har-man-dev/rocket-flight-computer/images/IMG_8844.jpeg

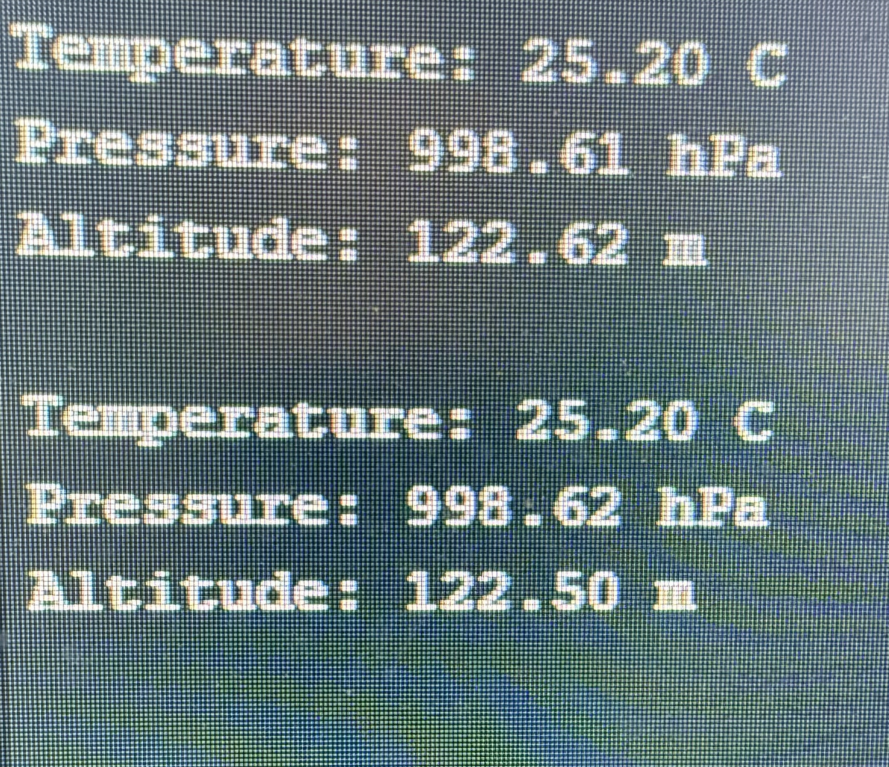
images/IMG_8844.jpeg
