har-man-dev/rocket-flight-computer/images/IMG_8843.jpeg

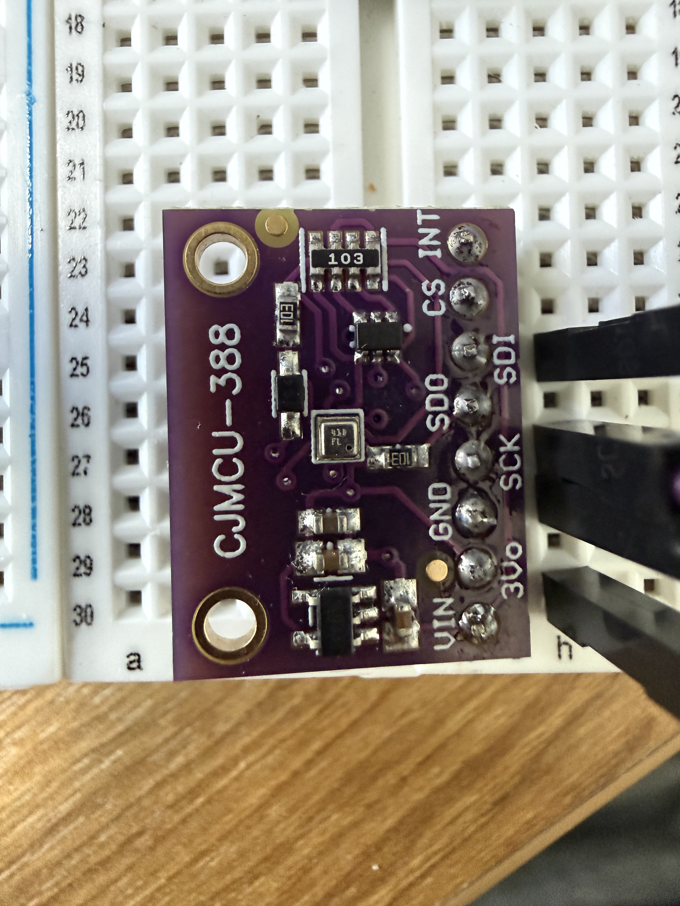
images/IMG_8843.jpeg
