har-man-dev/rocket-flight-computer/images/IMG_8841.jpeg

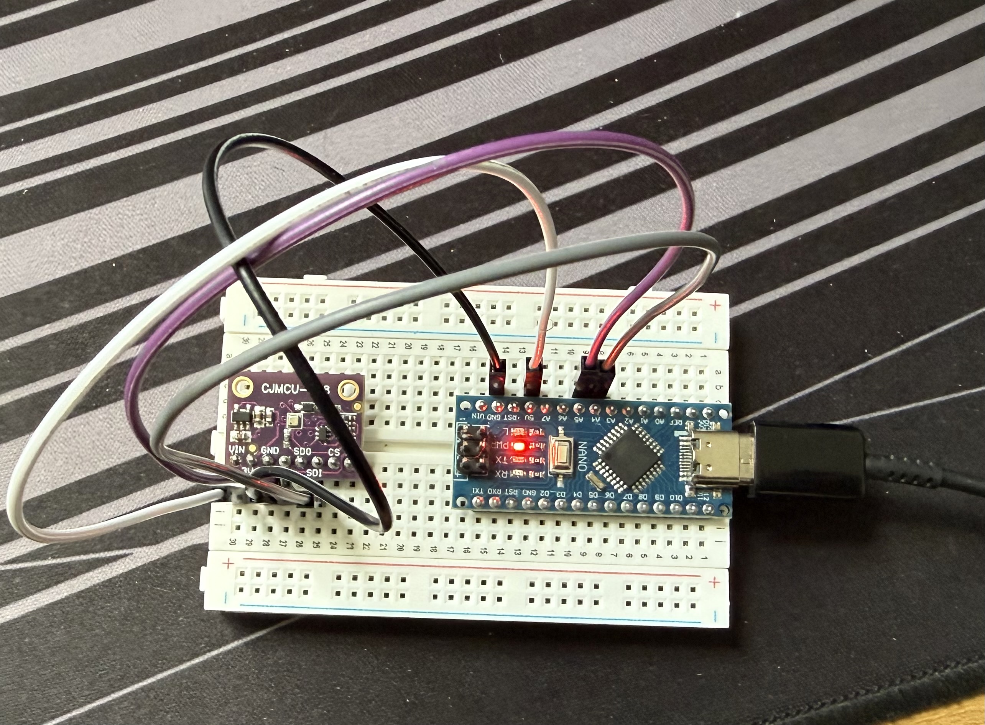
images/IMG_8841.jpeg
