har-man-dev/rocket-flight-computer/images/IMG_8845.jpeg

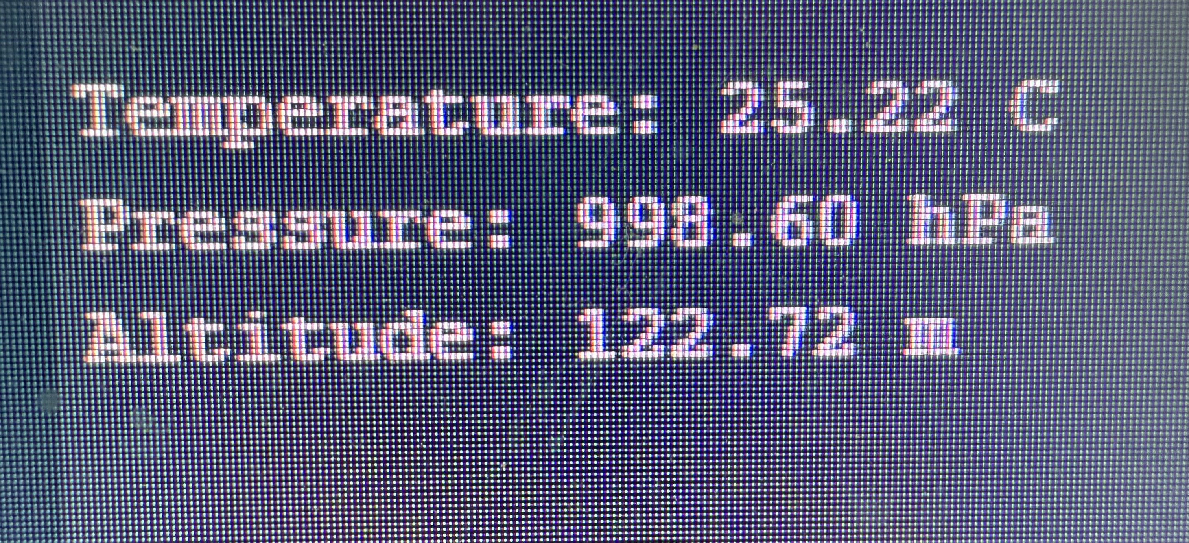
images/IMG_8845.jpeg
