har-man-dev/rocket-flight-computer/images/IMG_8846.jpeg

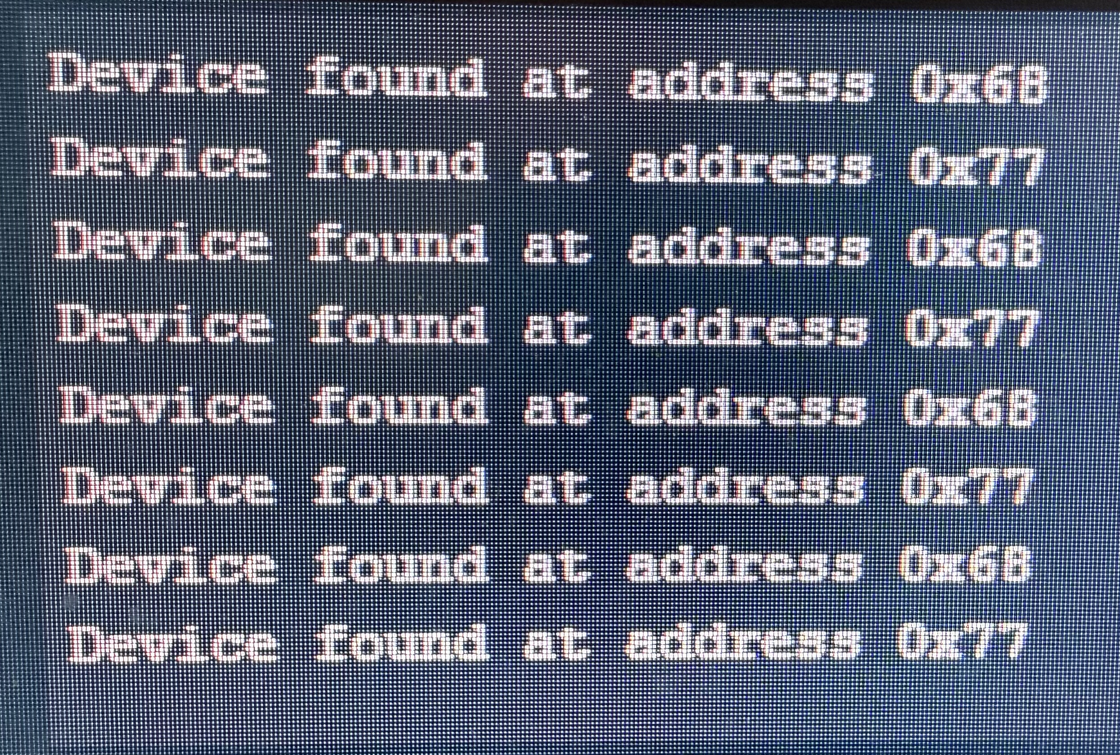
images/IMG_8846.jpeg
