har-man-dev/rocket-flight-computer/images/IMG_8848.jpeg

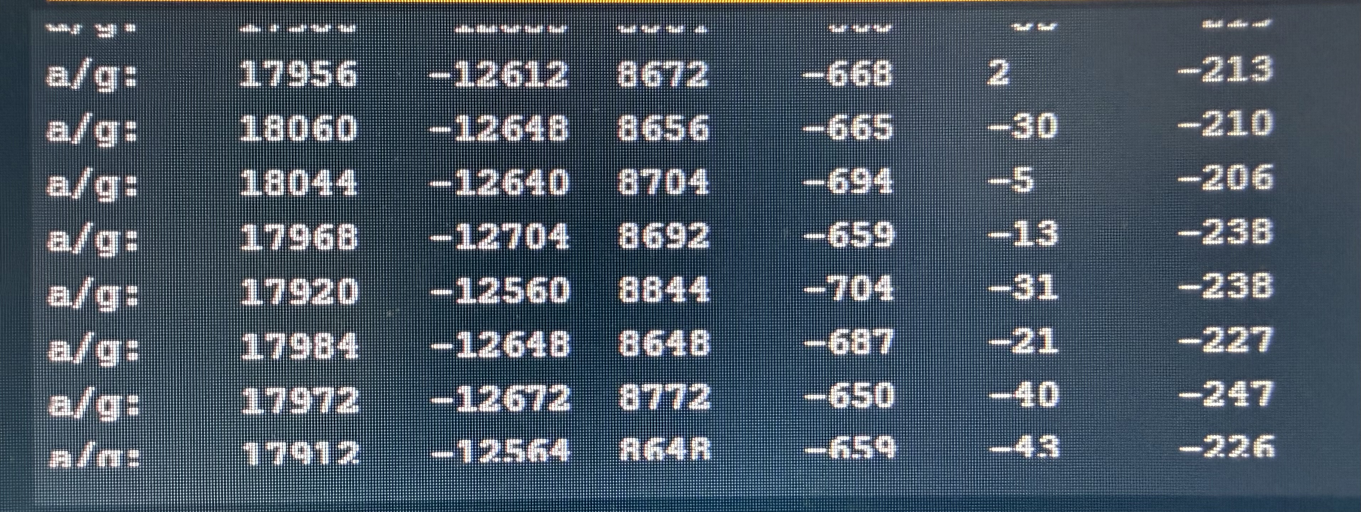
images/IMG_8848.jpeg
