har-man-dev/rocket-flight-computer/images/IMG_8849.jpeg

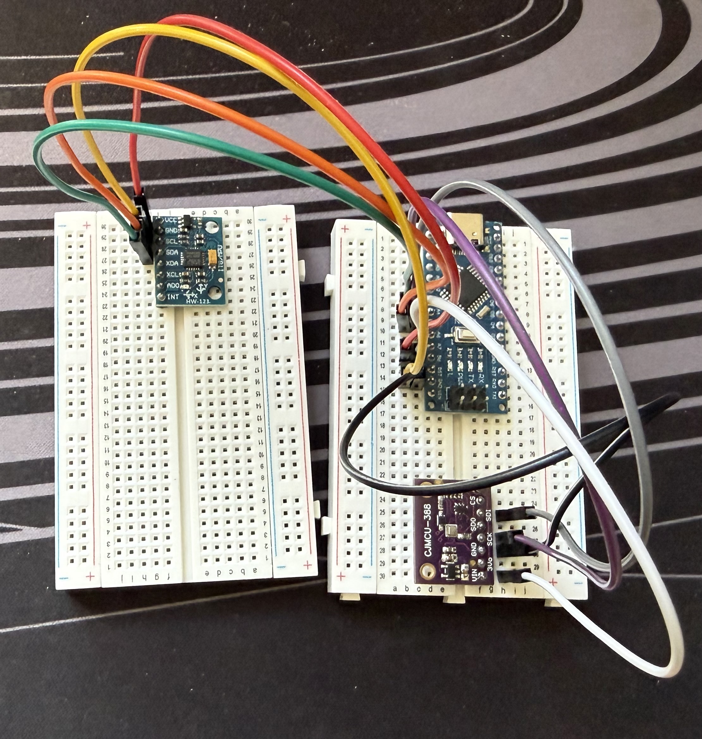
images/IMG_8849.jpeg
