har-man-dev/rocket-flight-computer/images/IMG_8850.jpeg

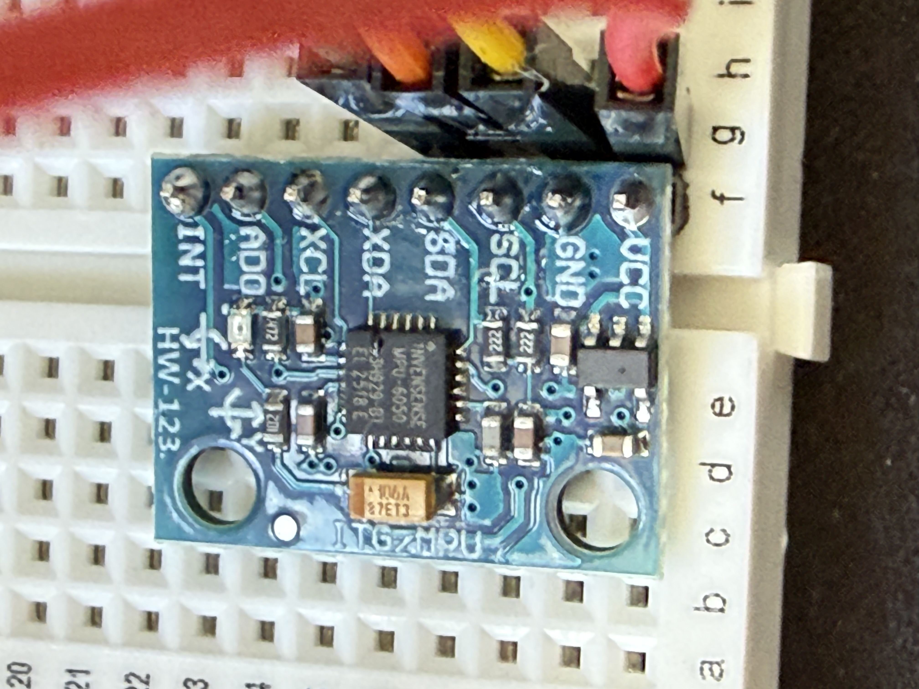
images/IMG_8850.jpeg
