har-man-dev/rocket-flight-computer/images/IMG_8851.jpeg

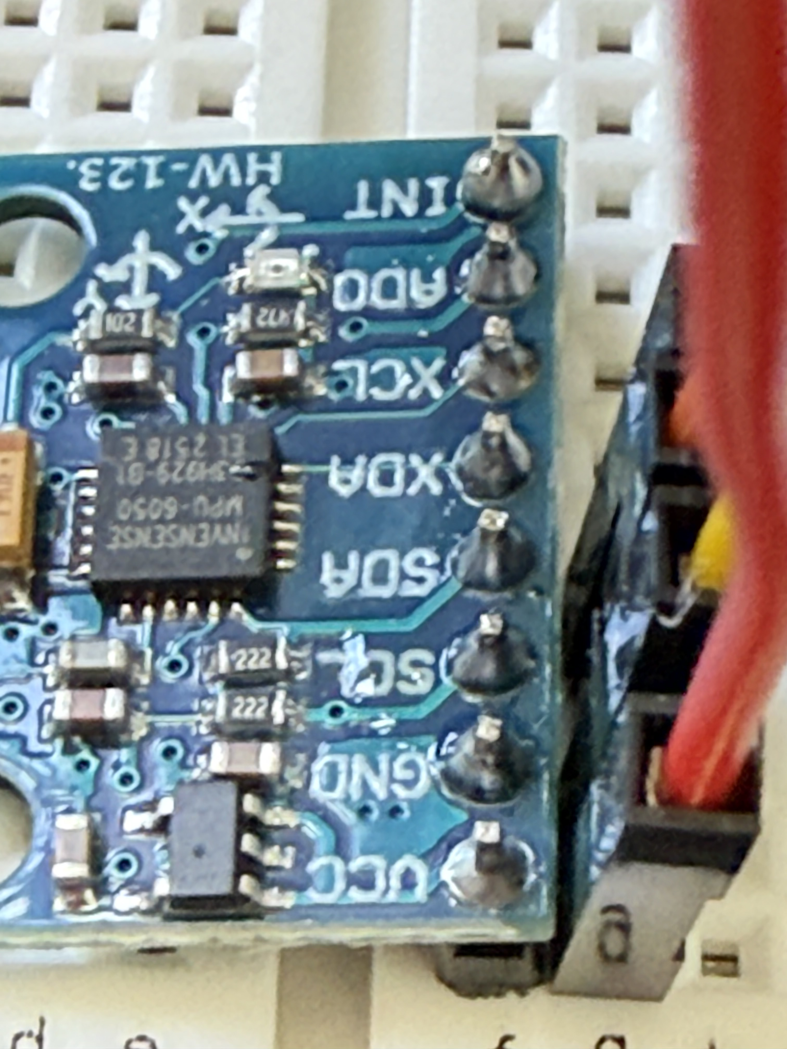
images/IMG_8851.jpeg
