har-man-dev/rocket-flight-computer/images/IMG_8867.jpeg

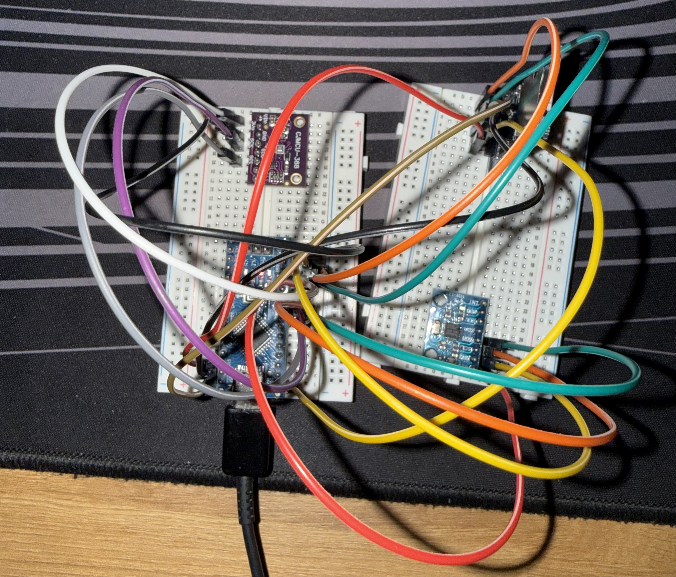
images/IMG_8867.jpeg
