har-man-dev/rocket-flight-computer/images/IMG_8871.jpeg

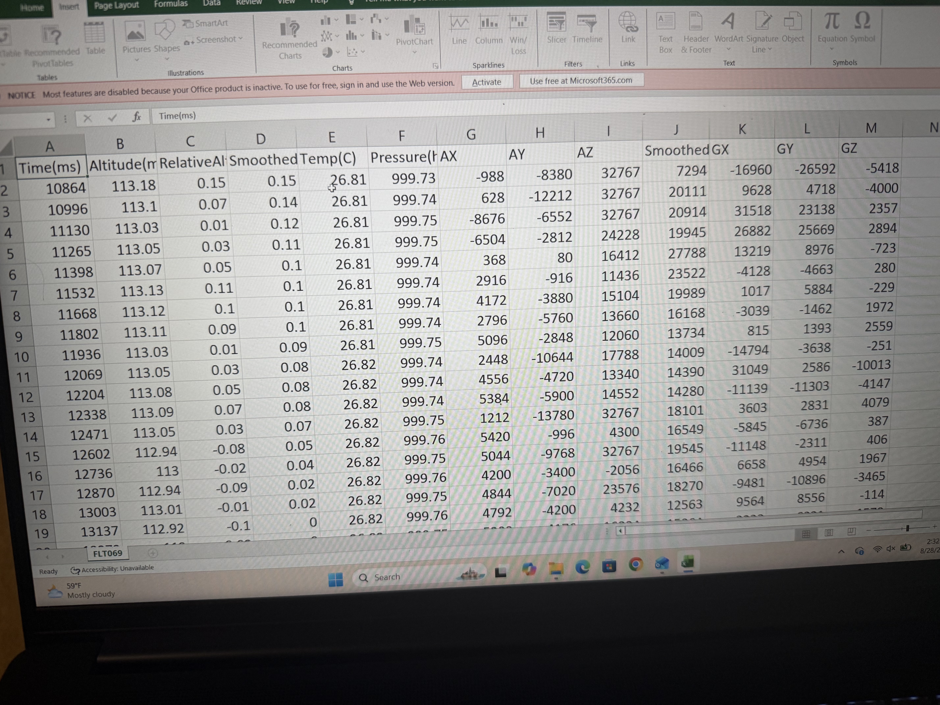
images/IMG_8871.jpeg
