har-man-dev/rocket-flight-computer/images/IMG_8945.jpeg

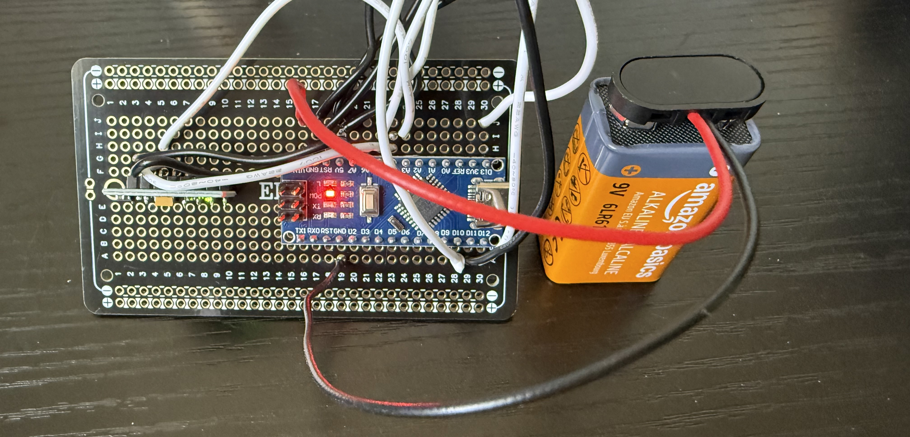
images/IMG_8945.jpeg
