har-man-dev/rocket-flight-computer/images/IMG_8947.jpeg

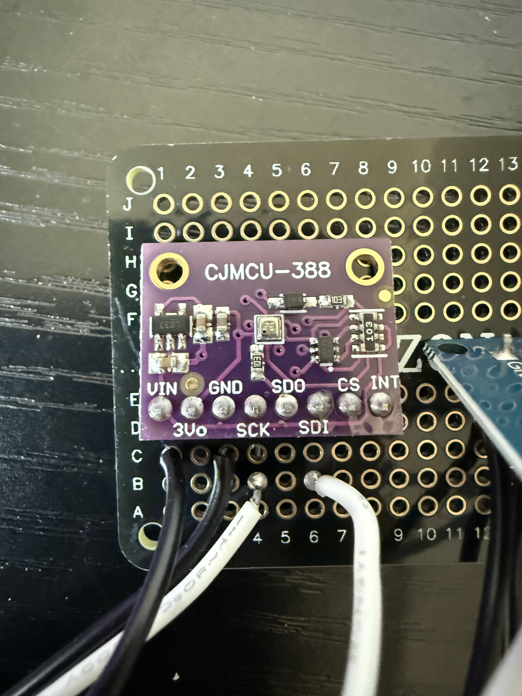
images/IMG_8947.jpeg
