har-man-dev/rocket-flight-computer/images/IMG_8948.jpeg

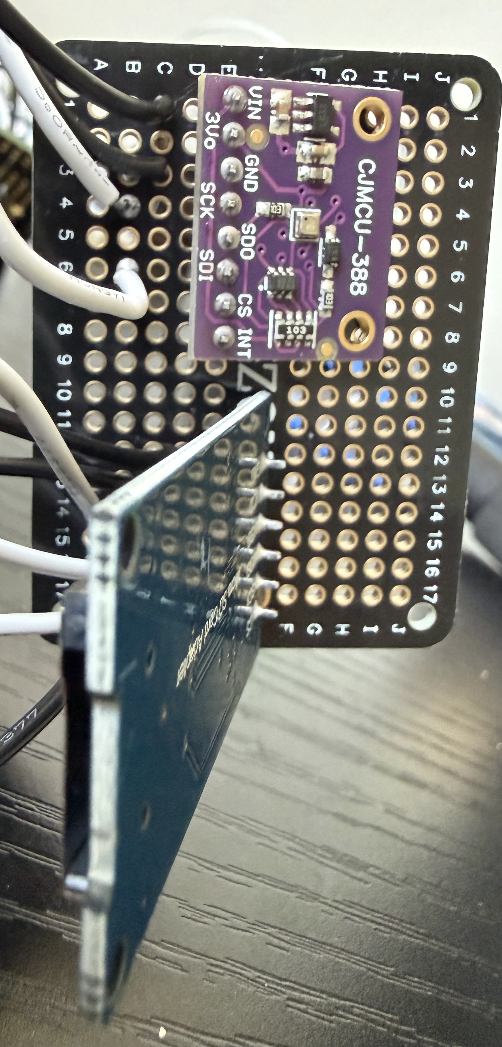
images/IMG_8948.jpeg
