har-man-dev/rocket-flight-computer/flight-logs/FLT008.CSV

Time(ms) | Altitude(m) | RelativeAlt(m) | SmoothedAlt(m) | Temp(C) | Pressure(hPa) | AX | AY | AZ | SmoothedAZ | GX | GY | GZ
13604 | 78.03 | 0.10 | -0.03 | 24.61 | 1003.91 | 32767 | 2618 | -27682 | -5325 | 32767 | 25041 | 12795
13735 | 78.02 | 0.09 | -0.01 | 24.60 | 1003.91 | -9631 | -4407 | 20984 | -1372 | 32767 | 9962 | 32767
13870 | 78.11 | 0.18 | 0.01 | 24.60 | 1003.90 | 7037 | -10924 | -8496 | -2976 | -8521 | -12259 | -32768
14004 | 78.18 | 0.25 | 0.04 | 24.59 | 1003.89 | -21426 | -5506 | -3640 | -4315 | -16268 | 27977 | -32768
14138 | 78.14 | 0.20 | 0.06 | 24.59 | 1003.90 | 164 | -1513 | 369 | -3693 | -5415 | 5690 | -630
14271 | 78.08 | 0.15 | 0.08 | 24.58 | 1003.91 | 6198 | -121 | -1700 | 1503 | -1452 | 1721 | -9104
14407 | 78.12 | 0.19 | 0.09 | 24.58 | 1003.90 | 3427 | 493 | -1346 | -2962 | 4783 | -5402 | -4681
14541 | 78.24 | 0.31 | 0.12 | 24.57 | 1003.89 | 3496 | 788 | -1976 | -1658 | -225 | -9788 | -4295
14675 | 78.33 | 0.40 | 0.16 | 24.57 | 1003.88 | 1889 | 464 | -2003 | -1331 | 1672 | -8189 | 87
14809 | 78.45 | 0.52 | 0.20 | 24.57 | 1003.86 | 2210 | 610 | -1844 | -1773 | 1891 | -5512 | -738
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
