har-man-dev/rocket-flight-computer/flight-logs/FLT010.CSV

Time(ms) | Altitude(m) | RelativeAlt(m) | SmoothedAlt(m) | Temp(C) | Pressure(hPa) | AX | AY | AZ | SmoothedAZ | GX | GY | GZ
16124 | 79.19 | 0.27 | 0.18 | 24.24 | 1003.77 | -3928 | -6922 | -8536 | -2758 | -27584 | 2082 | -6062
16494 | 79.15 | 0.23 | 0.20 | 24.26 | 1003.78 | -10089 | -6897 | -7095 | -2944 | -15575 | -5153 | 32767
16630 | 79.18 | 0.25 | 0.21 | 24.27 | 1003.78 | -1996 | 14264 | 6716 | -2164 | 10288 | -485 | -26735
16764 | 79.10 | 0.18 | 0.20 | 24.28 | 1003.78 | -4325 | -8893 | -5976 | -1652 | 6311 | 6366 | -3670
16899 | 79.12 | 0.19 | 0.20 | 24.29 | 1003.78 | -8339 | -12595 | -10509 | -4089 | -12498 | -13892 | 32767
17033 | 79.18 | 0.25 | 0.21 | 24.29 | 1003.78 | -2507 | 6534 | 253 | -3322 | -6822 | -1272 | -24281
17170 | 79.18 | 0.25 | 0.21 | 24.30 | 1003.78 | -3622 | -1027 | -2680 | -2439 | -4781 | 3635 | 3676
17303 | 79.15 | 0.23 | 0.22 | 24.31 | 1003.78 | -2361 | -1928 | -2552 | -4292 | 3703 | 1796 | -1207
17437 | 79.09 | 0.17 | 0.21 | 24.31 | 1003.79 | -2928 | -2113 | -2994 | -3696 | 4794 | -24 | 2257
17571 | 79.11 | 0.19 | 0.21 | 24.32 | 1003.78 | -2470 | -1196 | -1841 | -1962 | 3993 | 2993 | 440
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
