har-man-dev/rocket-flight-computer/flight-logs/FLT008_graph.png

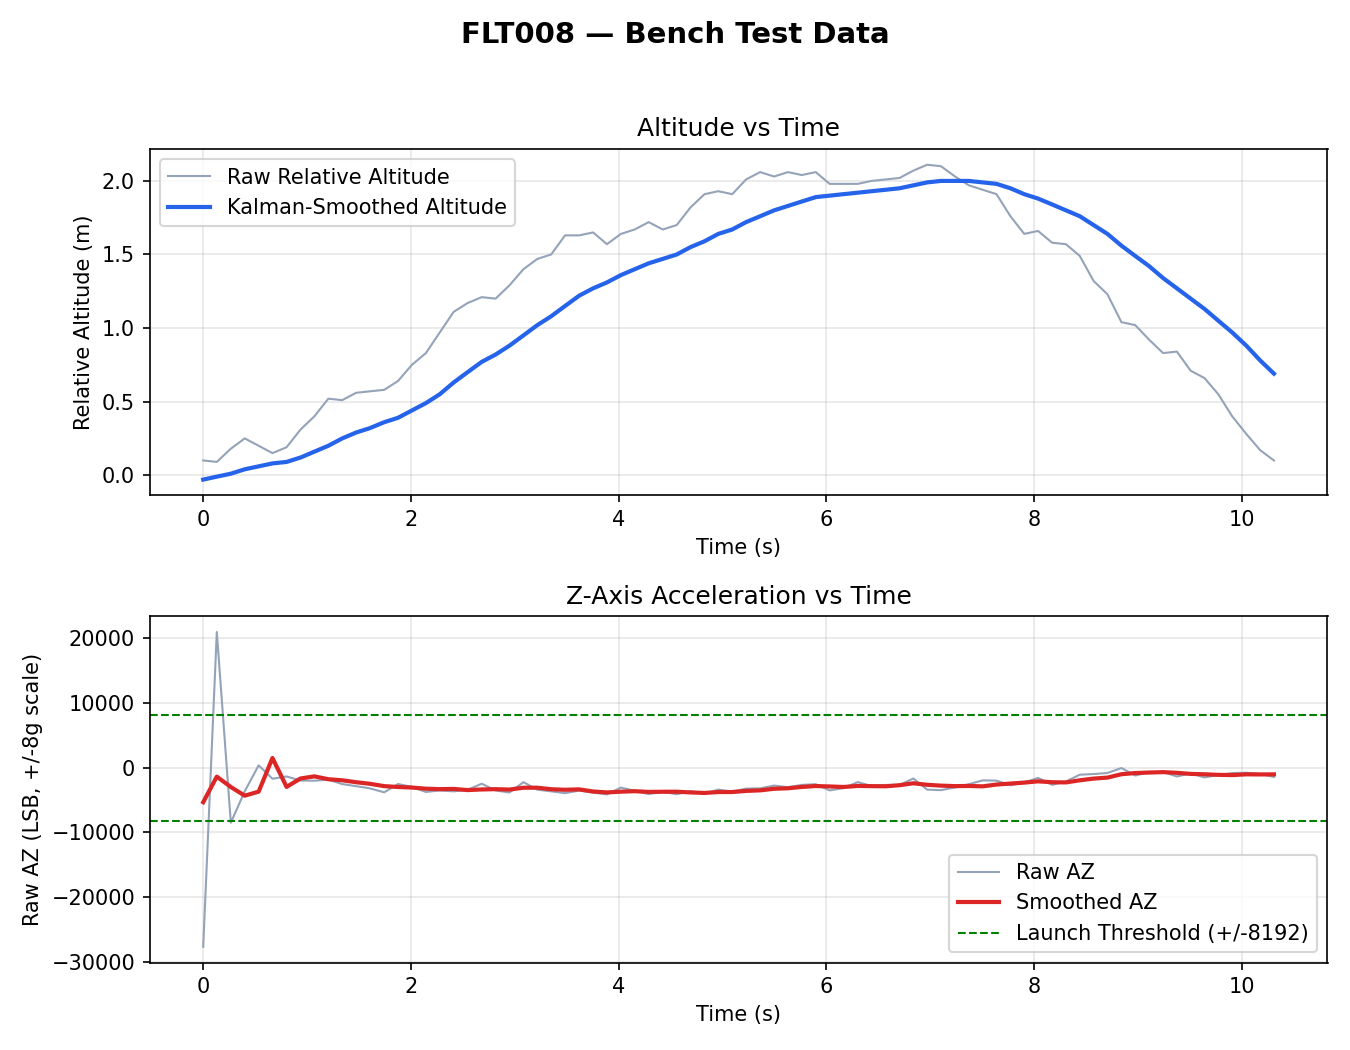
flight-logs/FLT008_graph.png
