har-man-dev/rocket-flight-computer/flight-logs/FLT010_graph.png

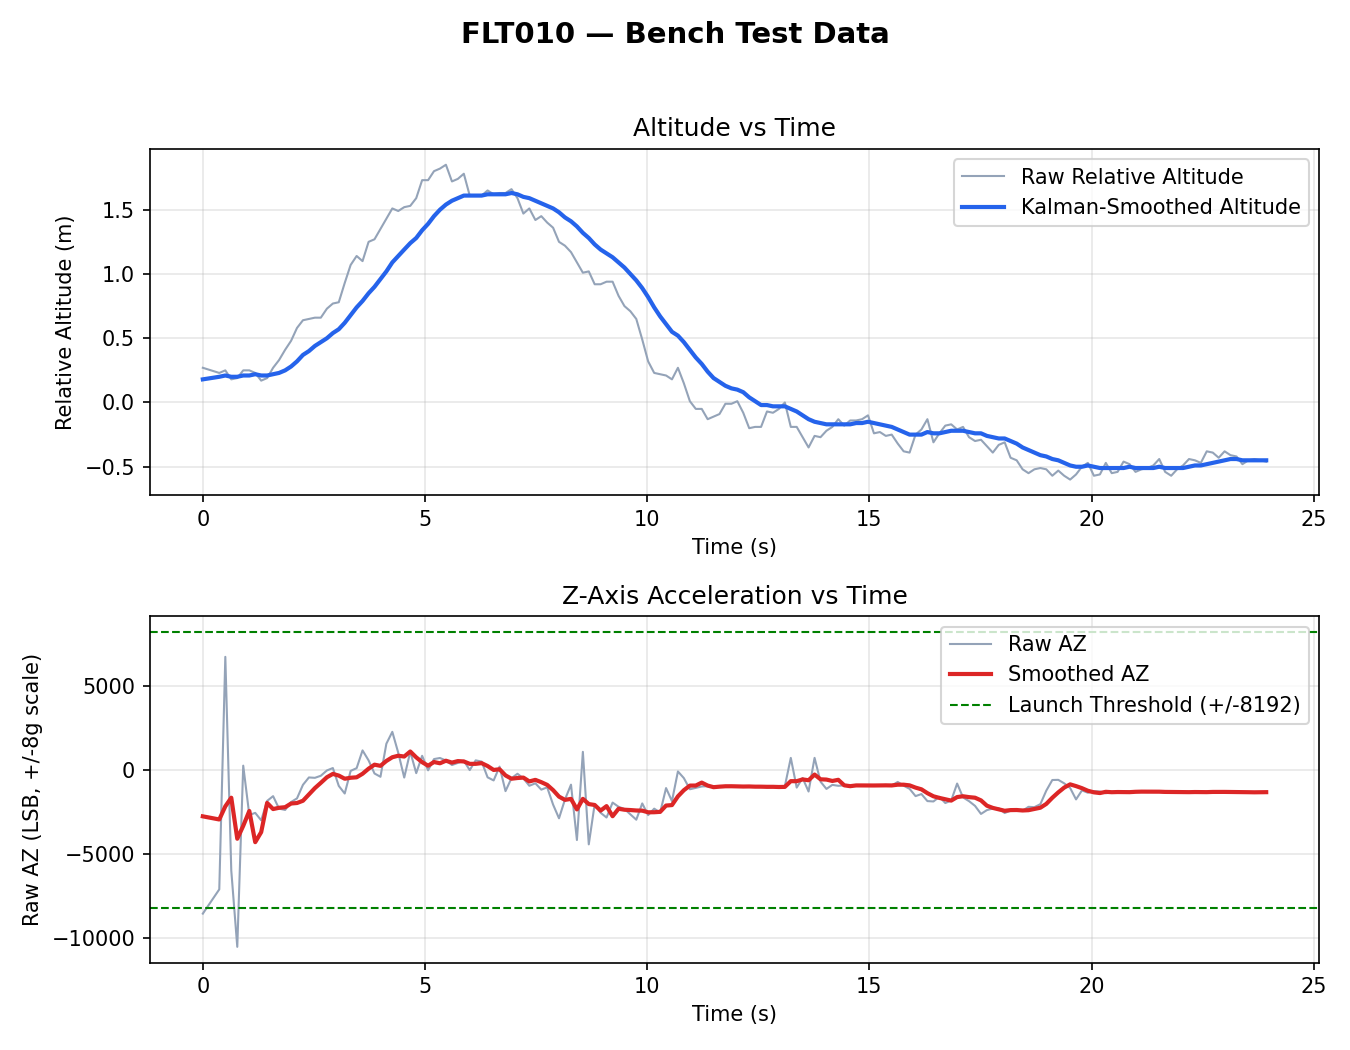
flight-logs/FLT010_graph.png
