har-man-dev/rocket-flight-computer/images/IMG_8870.jpeg

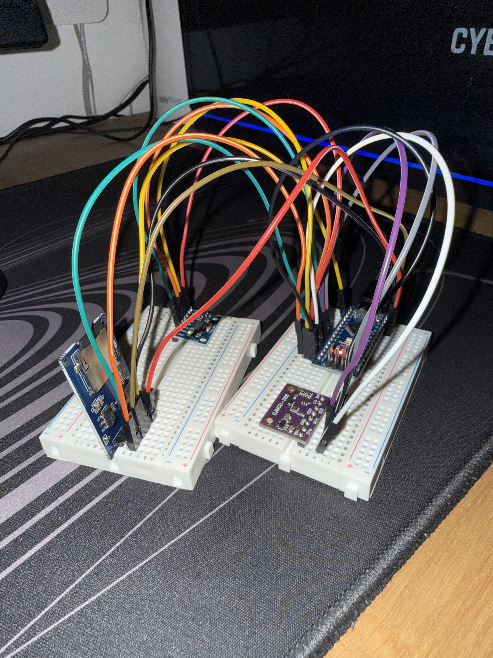
images/IMG_8870.jpeg
